Akupec/Plotr_RP/README.md

# Plotr_RP
Vývoj a stavba CNC plotru, ročníková práce
