Akupec/Plotr_RP/(list of files, cad)

Other CAD files:
modely/bearing_base.ipt
modely/bearing_holder.iam
modely/bearing_holder.idw
modely/bearing_holder.ipt
modely/bearing_standoff.ipt
modely/head.iam
modely/head.idw
modely/head_arm.ipt
modely/lift_tab.ipt
modely/lift_tab_bracket.ipt
modely/lifter.iam
modely/lifter.idw
modely/lifter_free_end.ipt
modely/lifter_rod.ipt
modely/lifter_servo_end.ipt
modely/panel.ipt
modely/standoff.ipt
modely/x_active.iam
modely/x_active.idw
modely/x_bearing_holder.ipt
modely/x_bearing_tab.ipt
modely/x_belt_anchor.ipt
modely/x_bracket.ipt
modely/x_bracket_stepper.ipt
modely/x_holder.ipt
modely/x_passive.iam
modely/x_passive.idw
modely/x_rod.ipt
modely/y_anchor_holder.ipt
modely/y_bearing.ipt
modely/y_bearing_holder.ipt
modely/y_belt_anchor.ipt
modely/y_cable_adaptor_holder.ipt
modely/y_holder.iam
modely/y_holder.idw
modely/y_holder.ipt
modely/y_rod.ipt
modely/y_standoff.ipt
