Akupec/Plotr_RP/bearing_holder.pdf

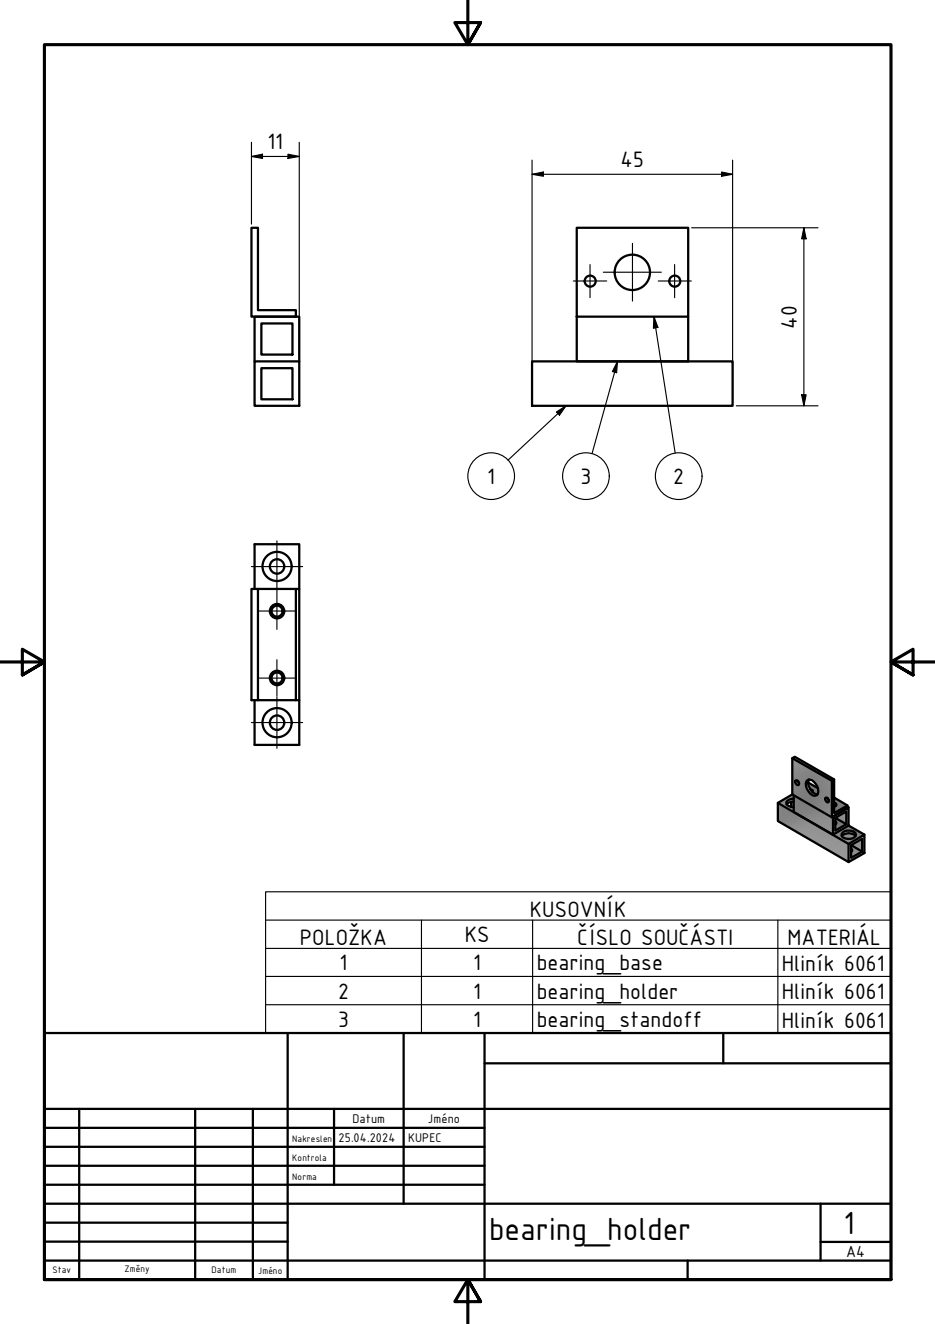
[picture p8: page 1]

POLOŽKA | KS | ČÍSLO SOUČÁSTI | MATERIÁL
1 | 1 | bearing_base | Hliník 6061
2 | 1 | bearing_holder | Hliník 6061
3 | 1 | bearing_standoff | Hliník 6061

Datum | Jméno

Nakreslen | 25.04.2024 | KUPEC

Kontrola

Norma
