Akupec/Plotr_RP/head.pdf

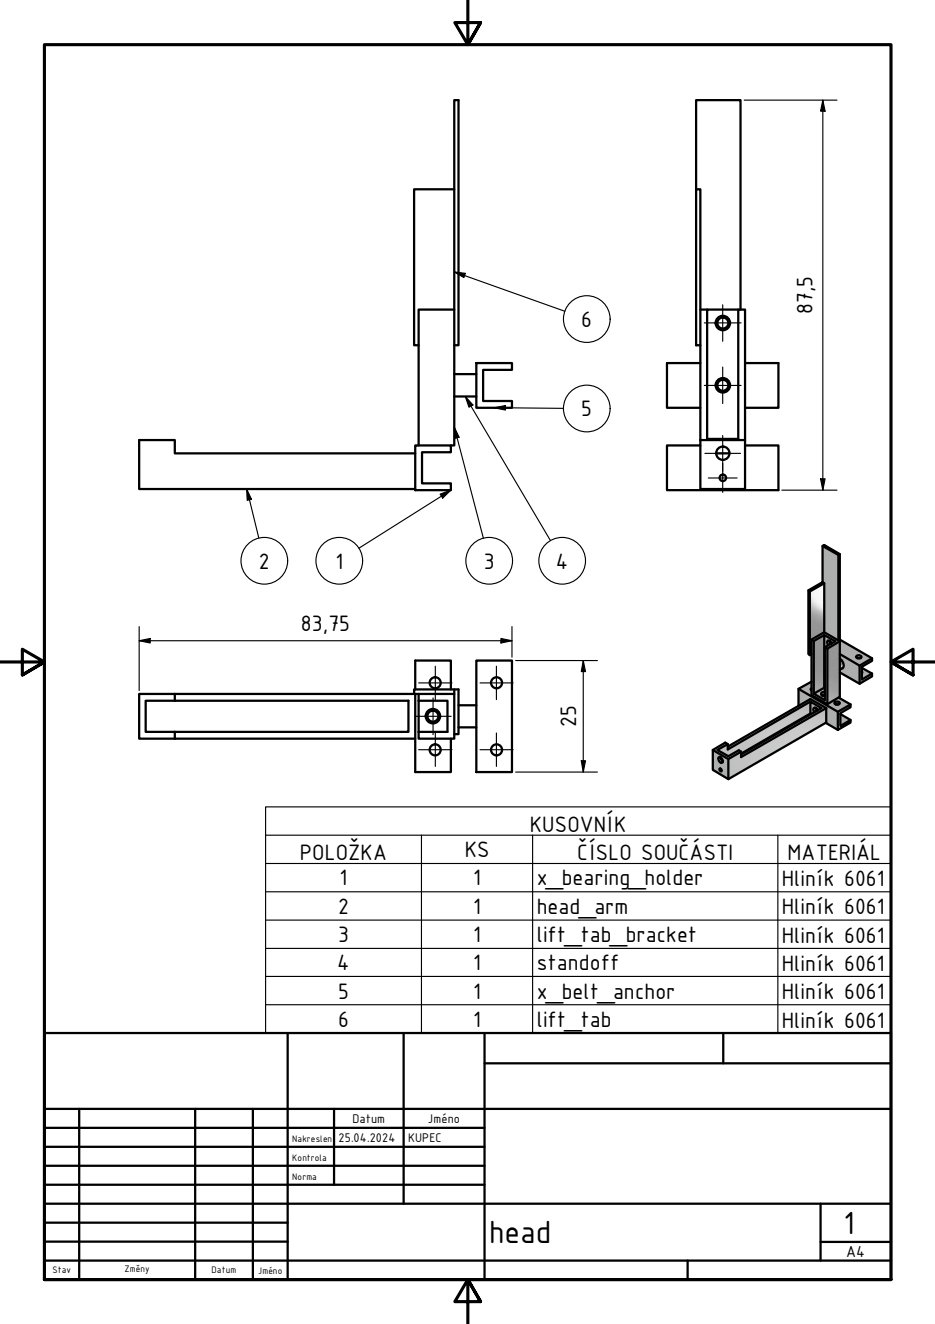
[picture p9: page 1]

POLOŽKA | KS | ČÍSLO SOUČÁSTI | MATERIÁL
1 | 1 | x_bearing_holder | Hliník 6061
2 | 1 | head_arm | Hliník 6061
3 | 1 | lift_tab_bracket | Hliník 6061
4 | 1 | standoff | Hliník 6061
5 | 1 | x_belt_anchor | Hliník 6061
6 | 1 | lift_tab | Hliník 6061

Datum | Jméno

Nakreslen | 25.04.2024 | KUPEC

Kontrola

Norma
