Akupec/Plotr_RP/x_active.pdf

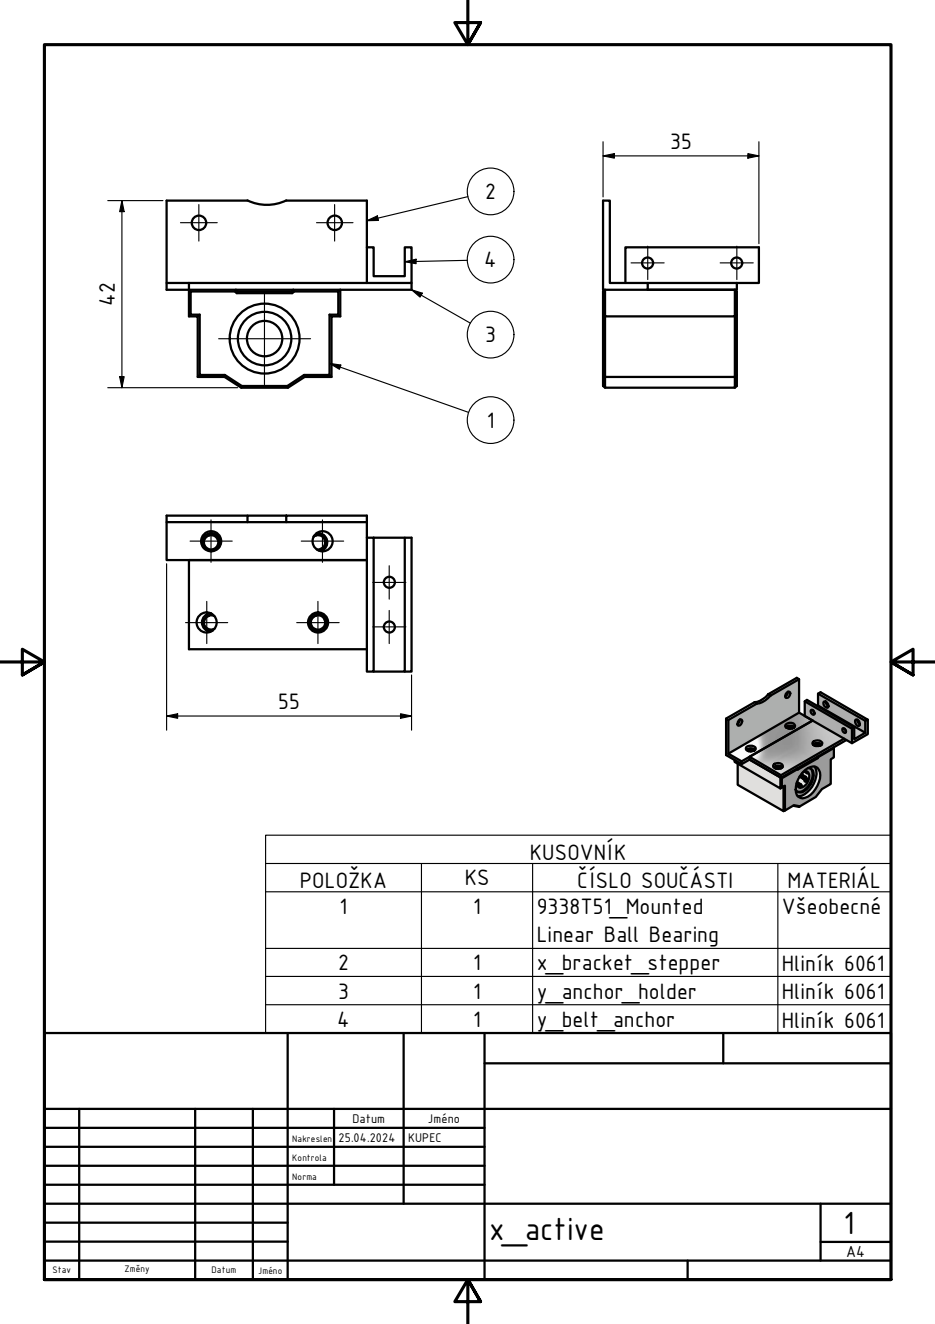
[picture p10: page 1]

POLOŽKA | KS | ČÍSLO SOUČÁSTI | MATERIÁL
1 | 1 | 9338T51_Mounted Linear Ball Bearing | Všeobecné

2 | 1 | x_bracket_stepper | Hliník 6061
3 | 1 | y_anchor_holder | Hliník 6061
4 | 1 | y_belt_anchor | Hliník 6061

Datum | Jméno

Nakreslen | 25.04.2024 | KUPEC

Kontrola

Norma
