Akupec/Plotr_RP/x_passive.pdf

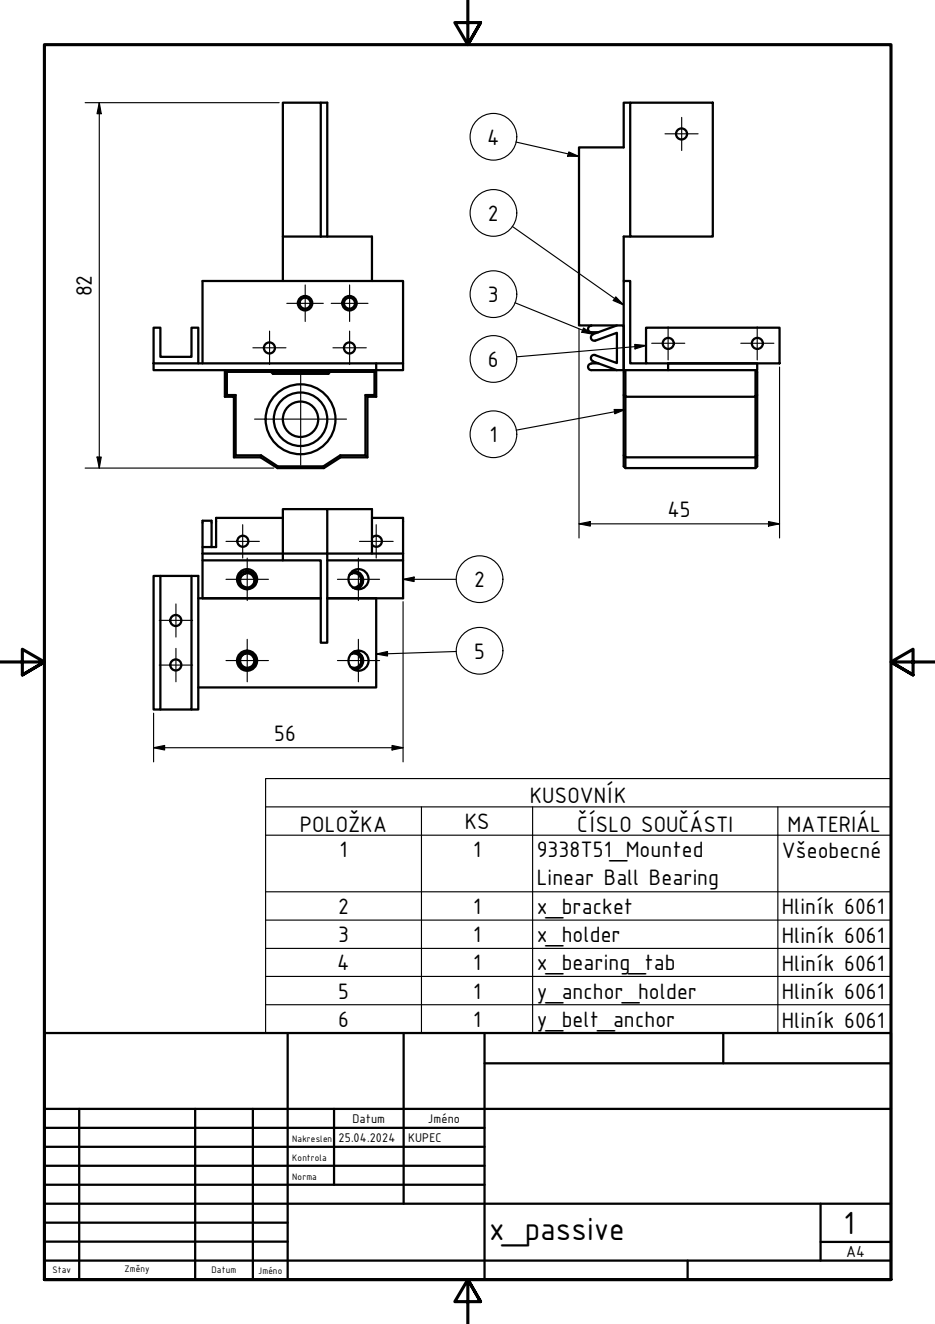
[picture p11: page 1]

POLOŽKA | KS | ČÍSLO SOUČÁSTI | MATERIÁL
1 | 1 | 9338T51_Mounted Linear Ball Bearing | Všeobecné

2 | 1 | x_bracket | Hliník 6061
3 | 1 | x_holder | Hliník 6061
4 | 1 | x_bearing_tab | Hliník 6061
5 | 1 | y_anchor_holder | Hliník 6061
6 | 1 | y_belt_anchor | Hliník 6061

Datum | Jméno

Nakreslen | 25.04.2024 | KUPEC

Kontrola

Norma
