Akupec/Plotr_RP/Schematic_RP.pdf

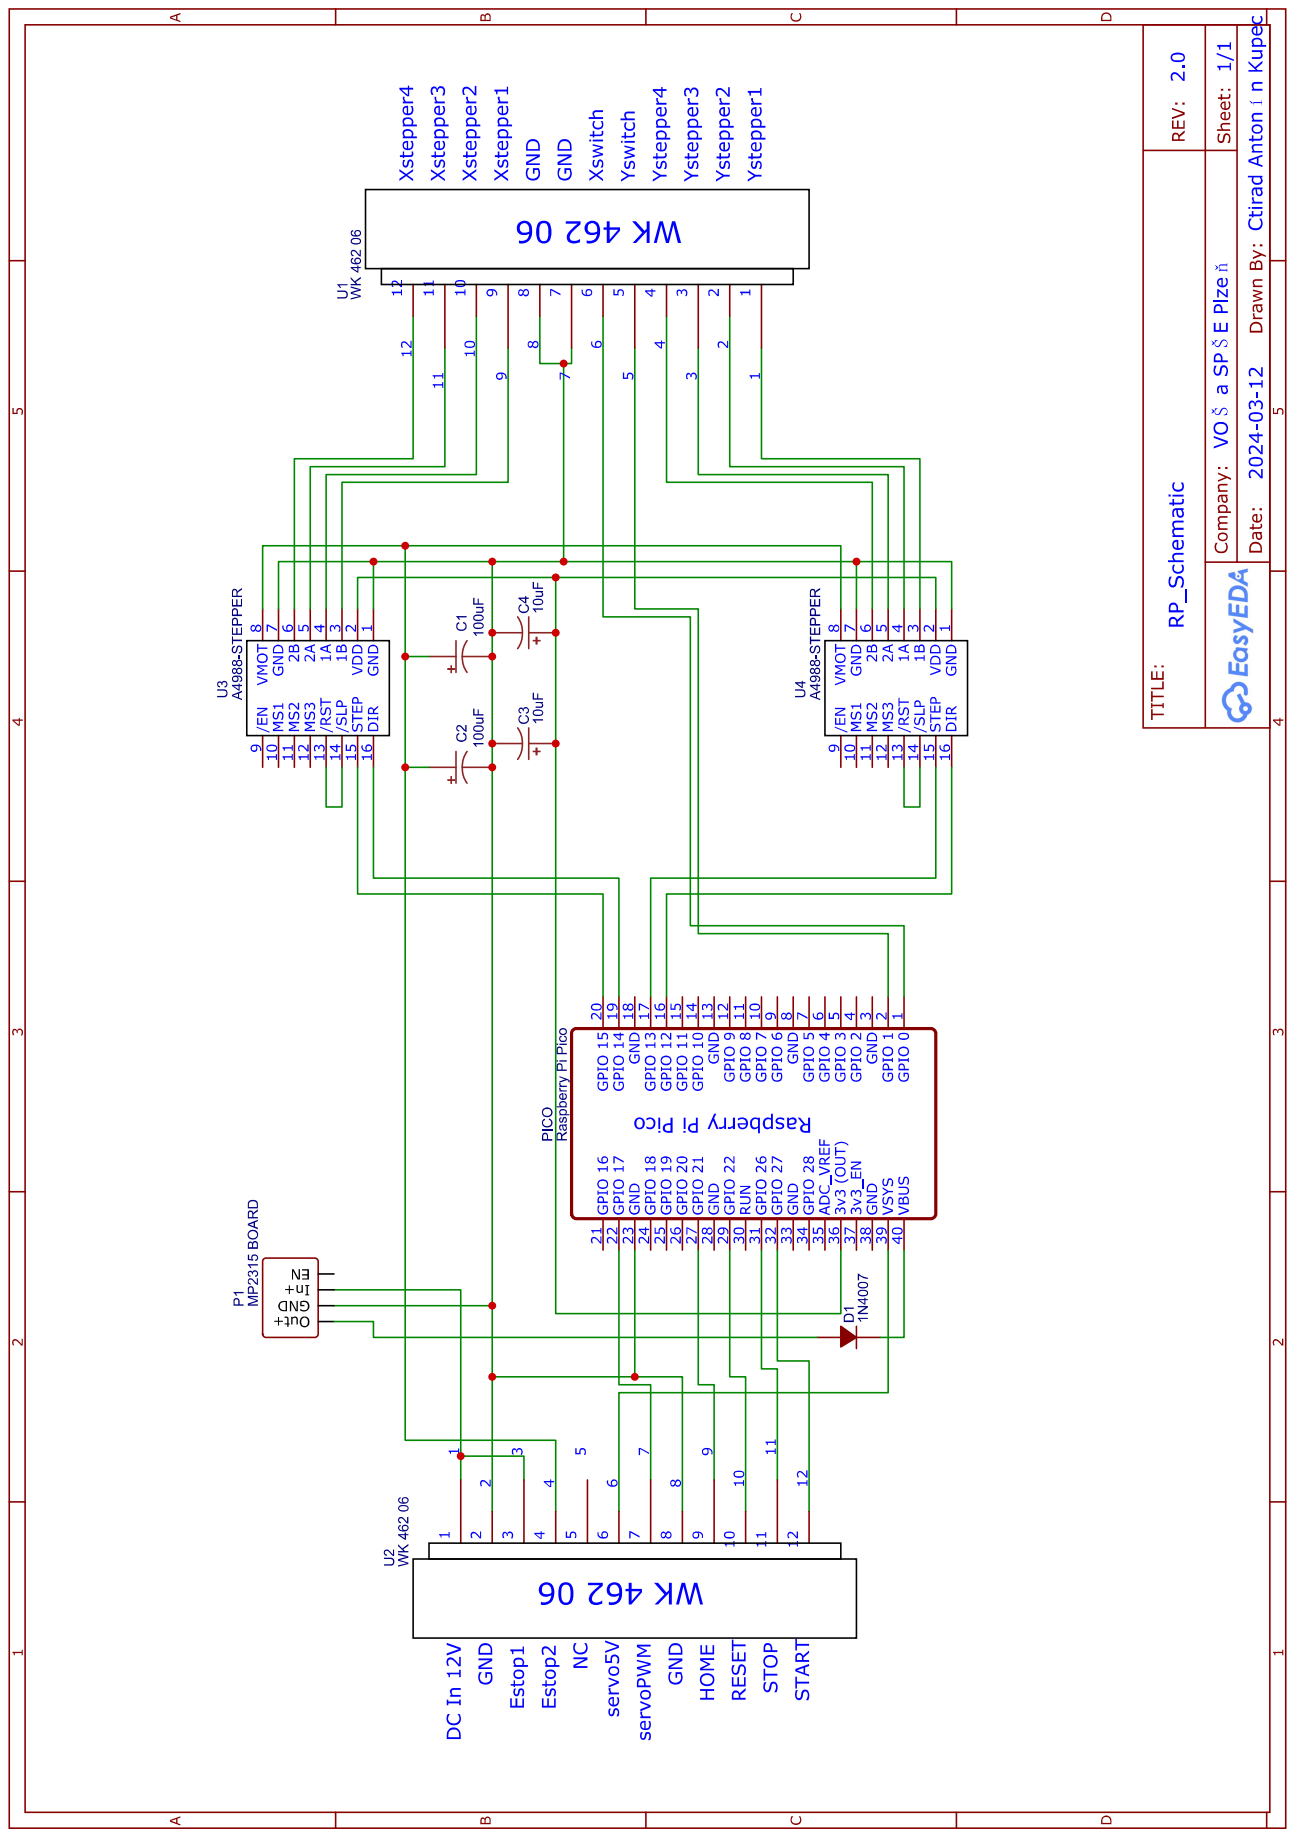
[picture p12: page 1]
