Akupec/Plotr_RP/lifter.pdf

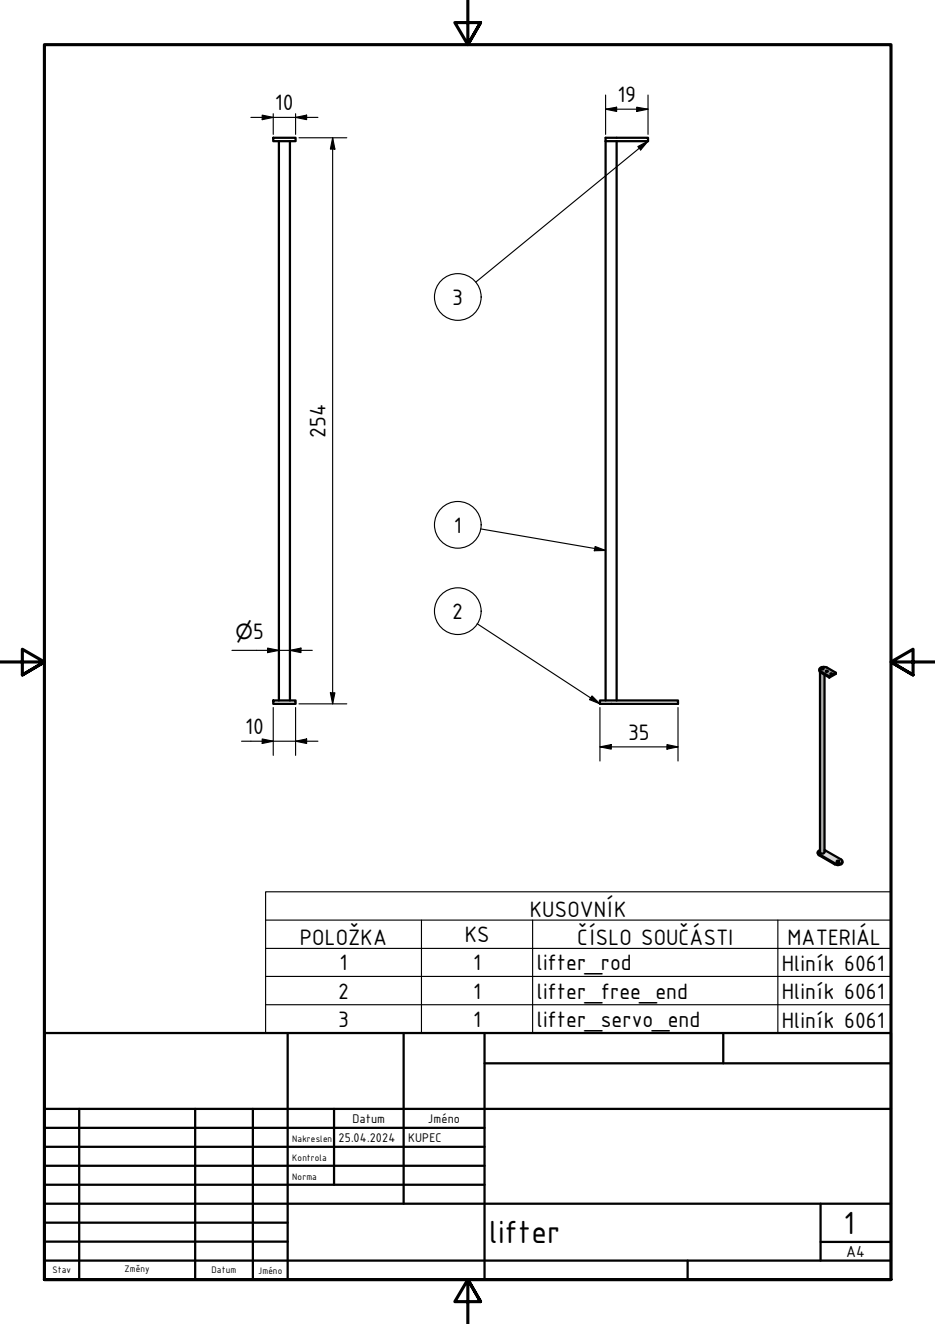
[picture p13: page 1]

POLOŽKA | KS | ČÍSLO SOUČÁSTI | MATERIÁL
1 | 1 | lifter_rod | Hliník 6061
2 | 1 | lifter_free_end | Hliník 6061
3 | 1 | lifter_servo_end | Hliník 6061

Datum | Jméno

Nakreslen | 25.04.2024 | KUPEC

Kontrola

Norma
