Akupec/Plotr_RP/y_holder.pdf

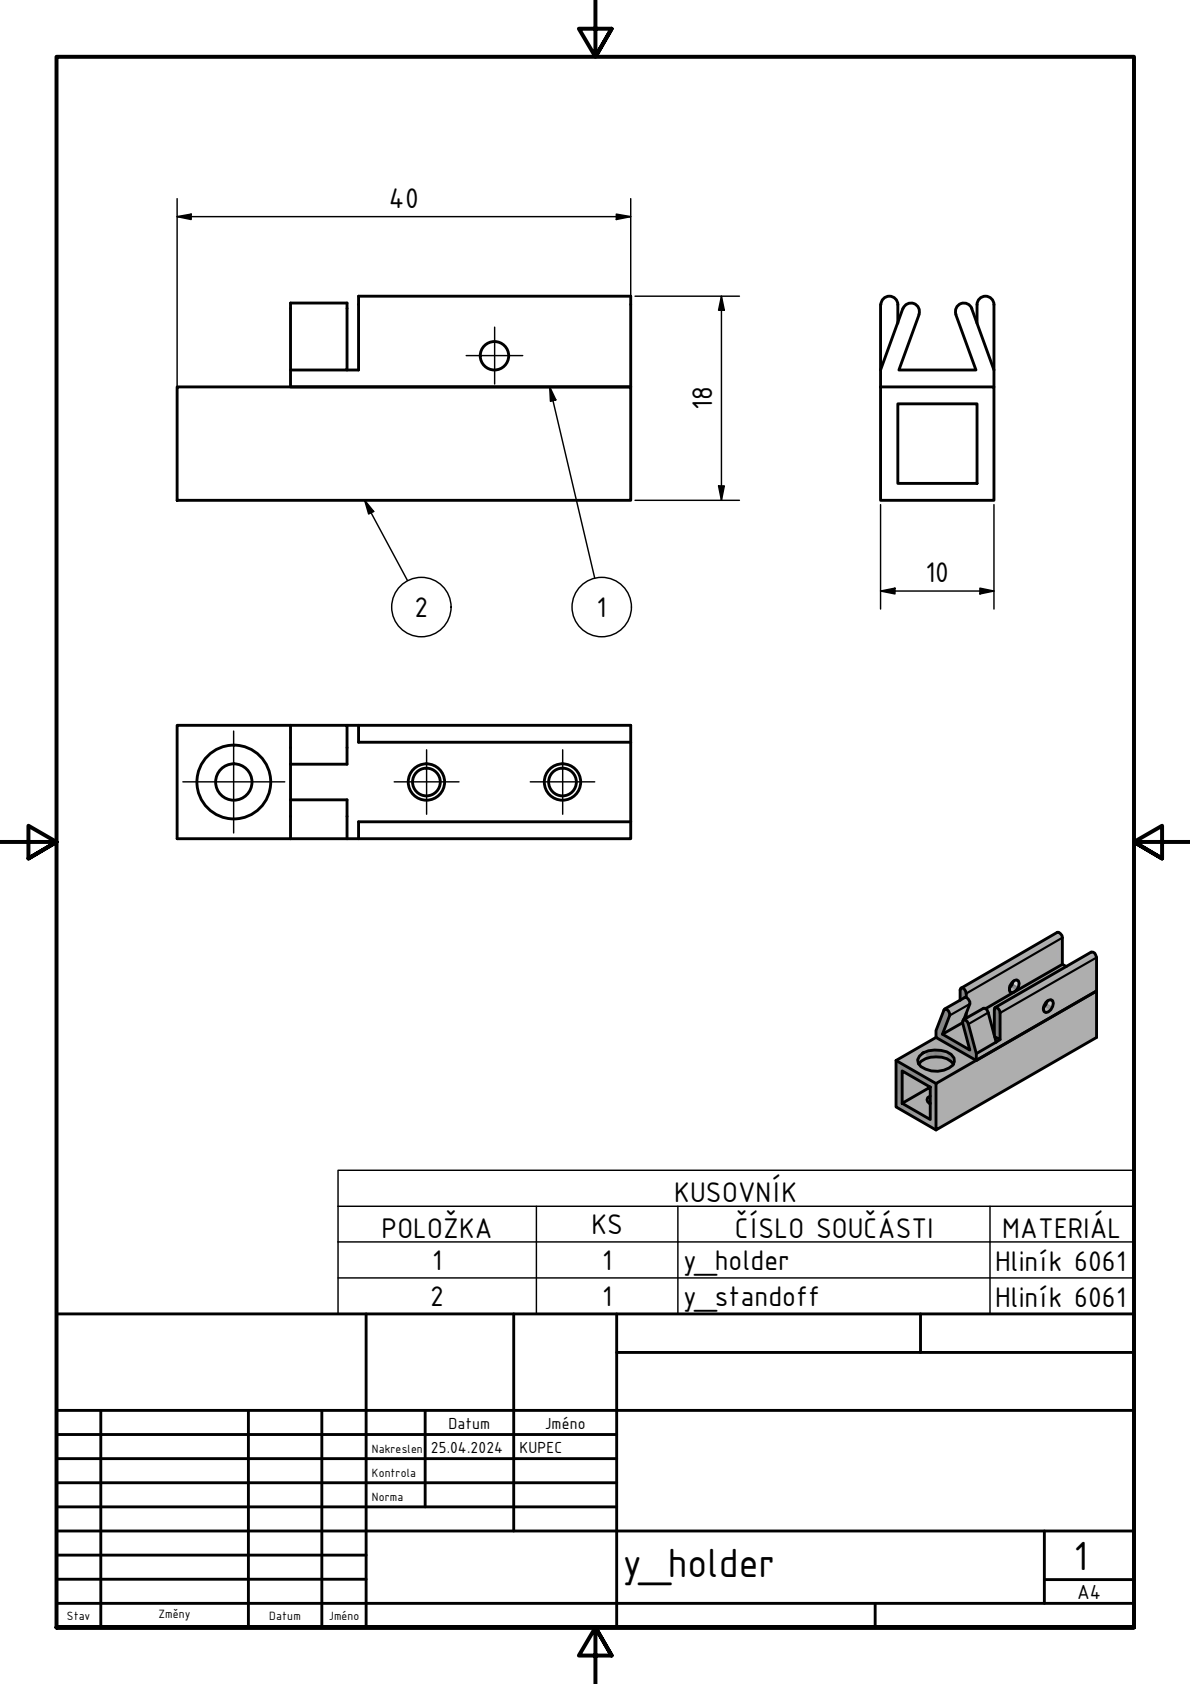
[picture p14: page 1]

POLOŽKA | KS | ČÍSLO SOUČÁSTI | MATERIÁL
1 | 1 | y_holder | Hliník 6061
2 | 1 | y_standoff | Hliník 6061

Datum | Jméno

Nakreslen | 25.04.2024 | KUPEC

Kontrola

Norma
